jarnevanmulders/IoT_energystorage_charger/README.md

# IoT energystorage charger

Designed to charge single LTO (Lithium Titanate Oxide) cell.

## Onboard features
- Constant current constant voltage buck converter charger.
- Overvoltage and undervoltage protection.
- MCU enter _stop mode_ when not charging.
- Load switches to disconnect LTO cell from buck converter output.

## Image hardware
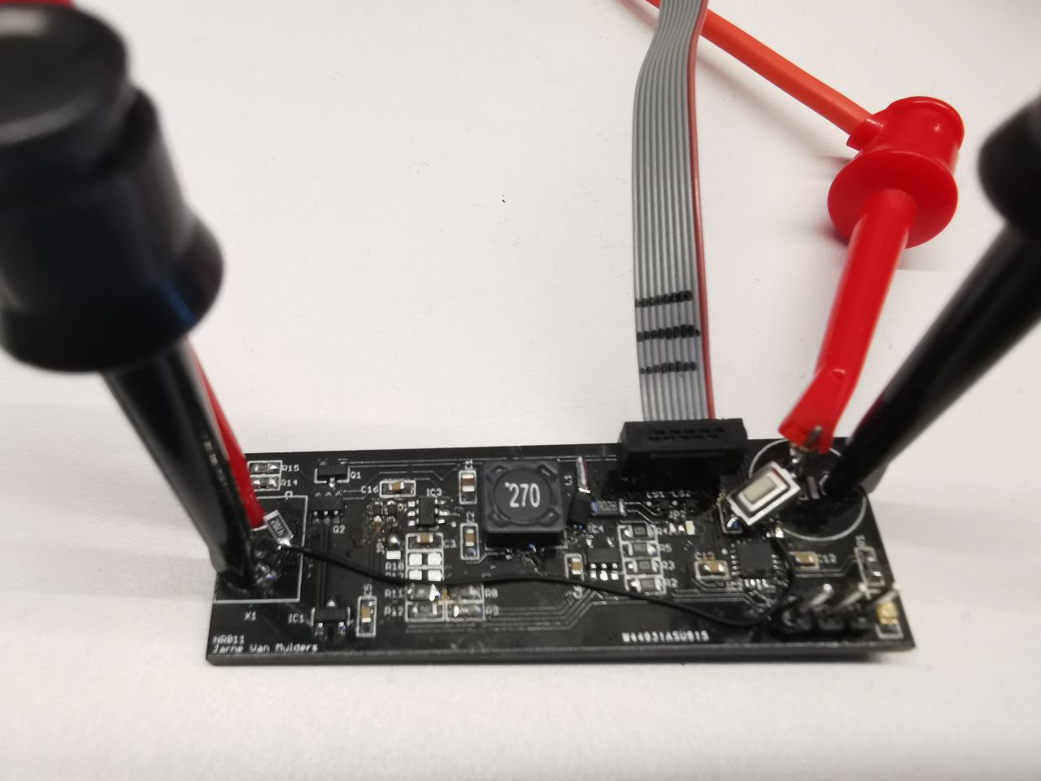
[picture p1: images/Hardware-image-1.jpg]
Image hardware
