jarnevanmulders/IoT_energystorage_charger/eagle-files/SVG-files/top.png

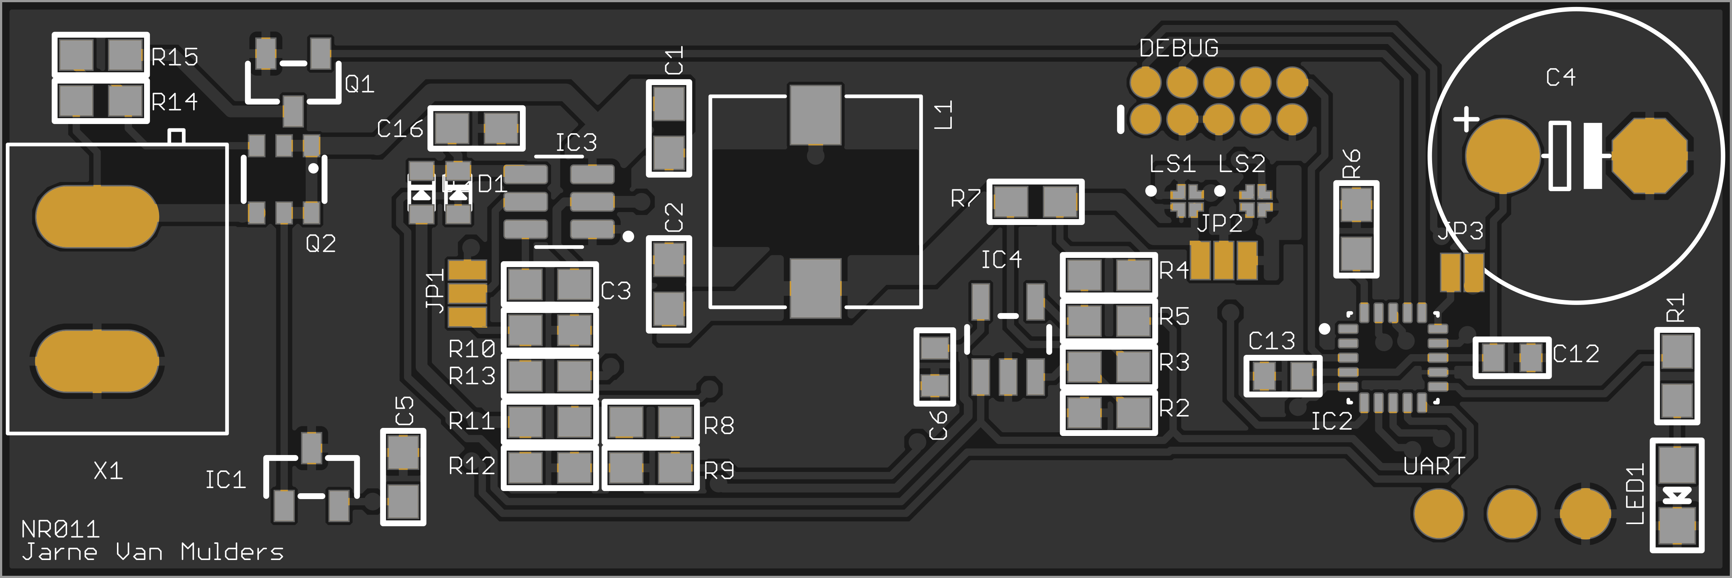
eagle-files/SVG-files/top.png
