jarnevanmulders/IoT_energystorage_charger/eagle-files/design1.pdf

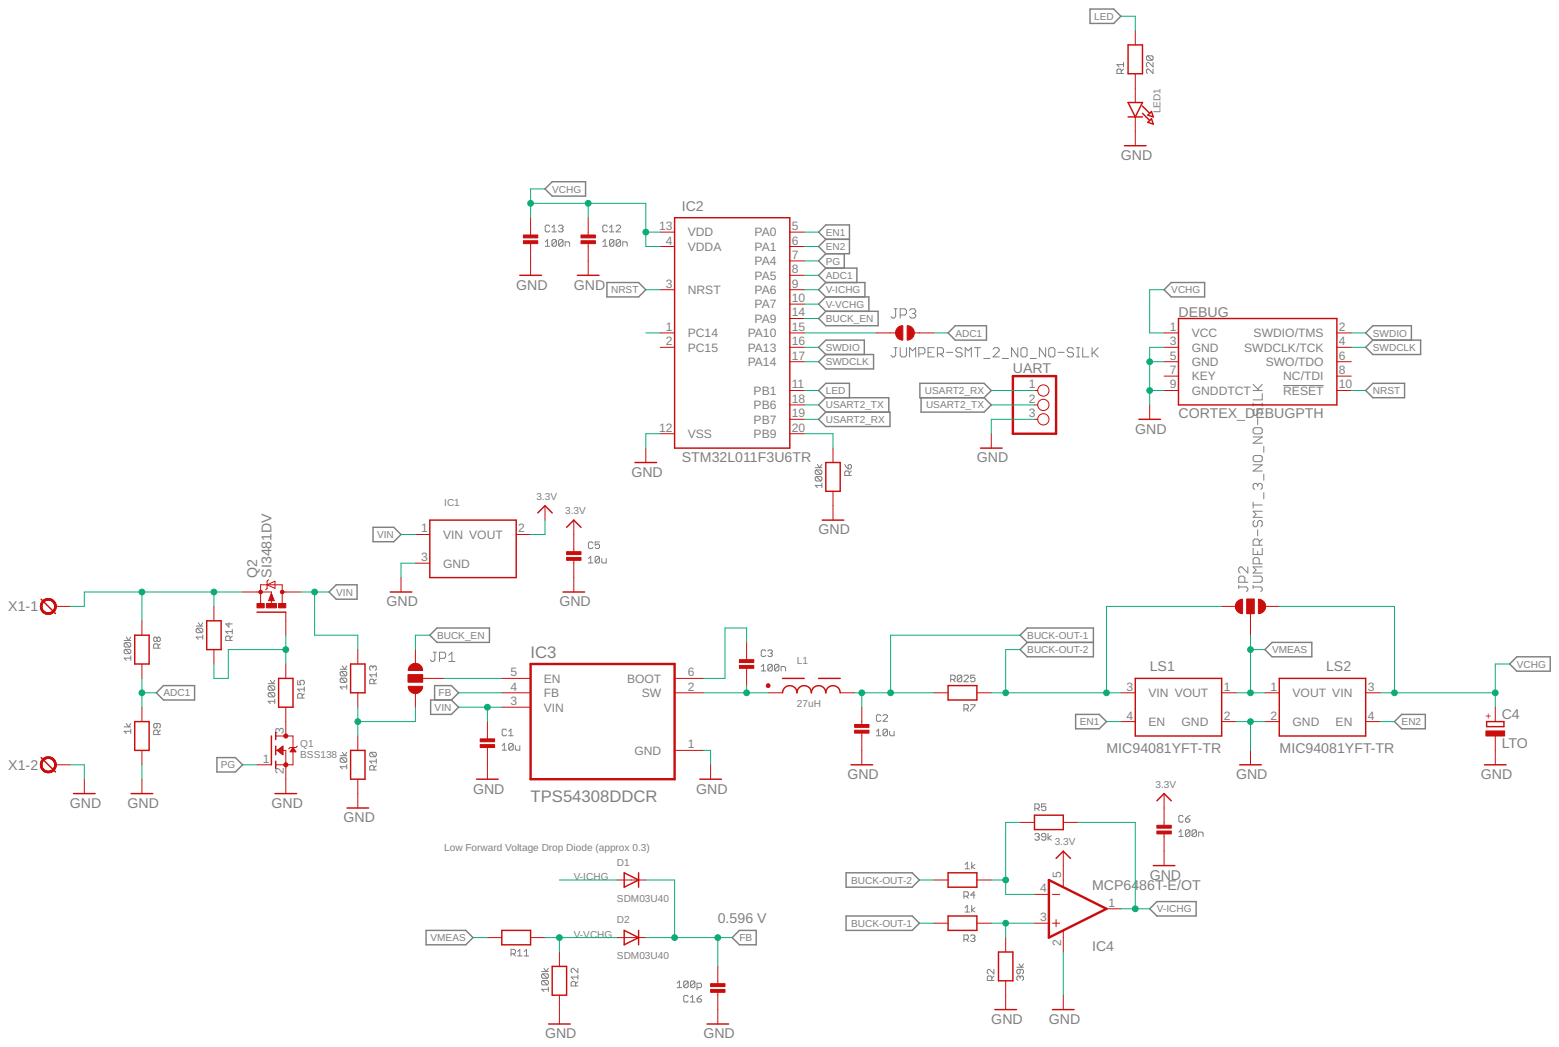
[picture p3: page 1]

Low Forward Voltage Drop Diode (approx 0.3)
