jarnevanmulders/IoT_energystorage_charger/eagle-files/design1.sch

## EAGLE design eagle-files/design1.sch (2023-06-15)

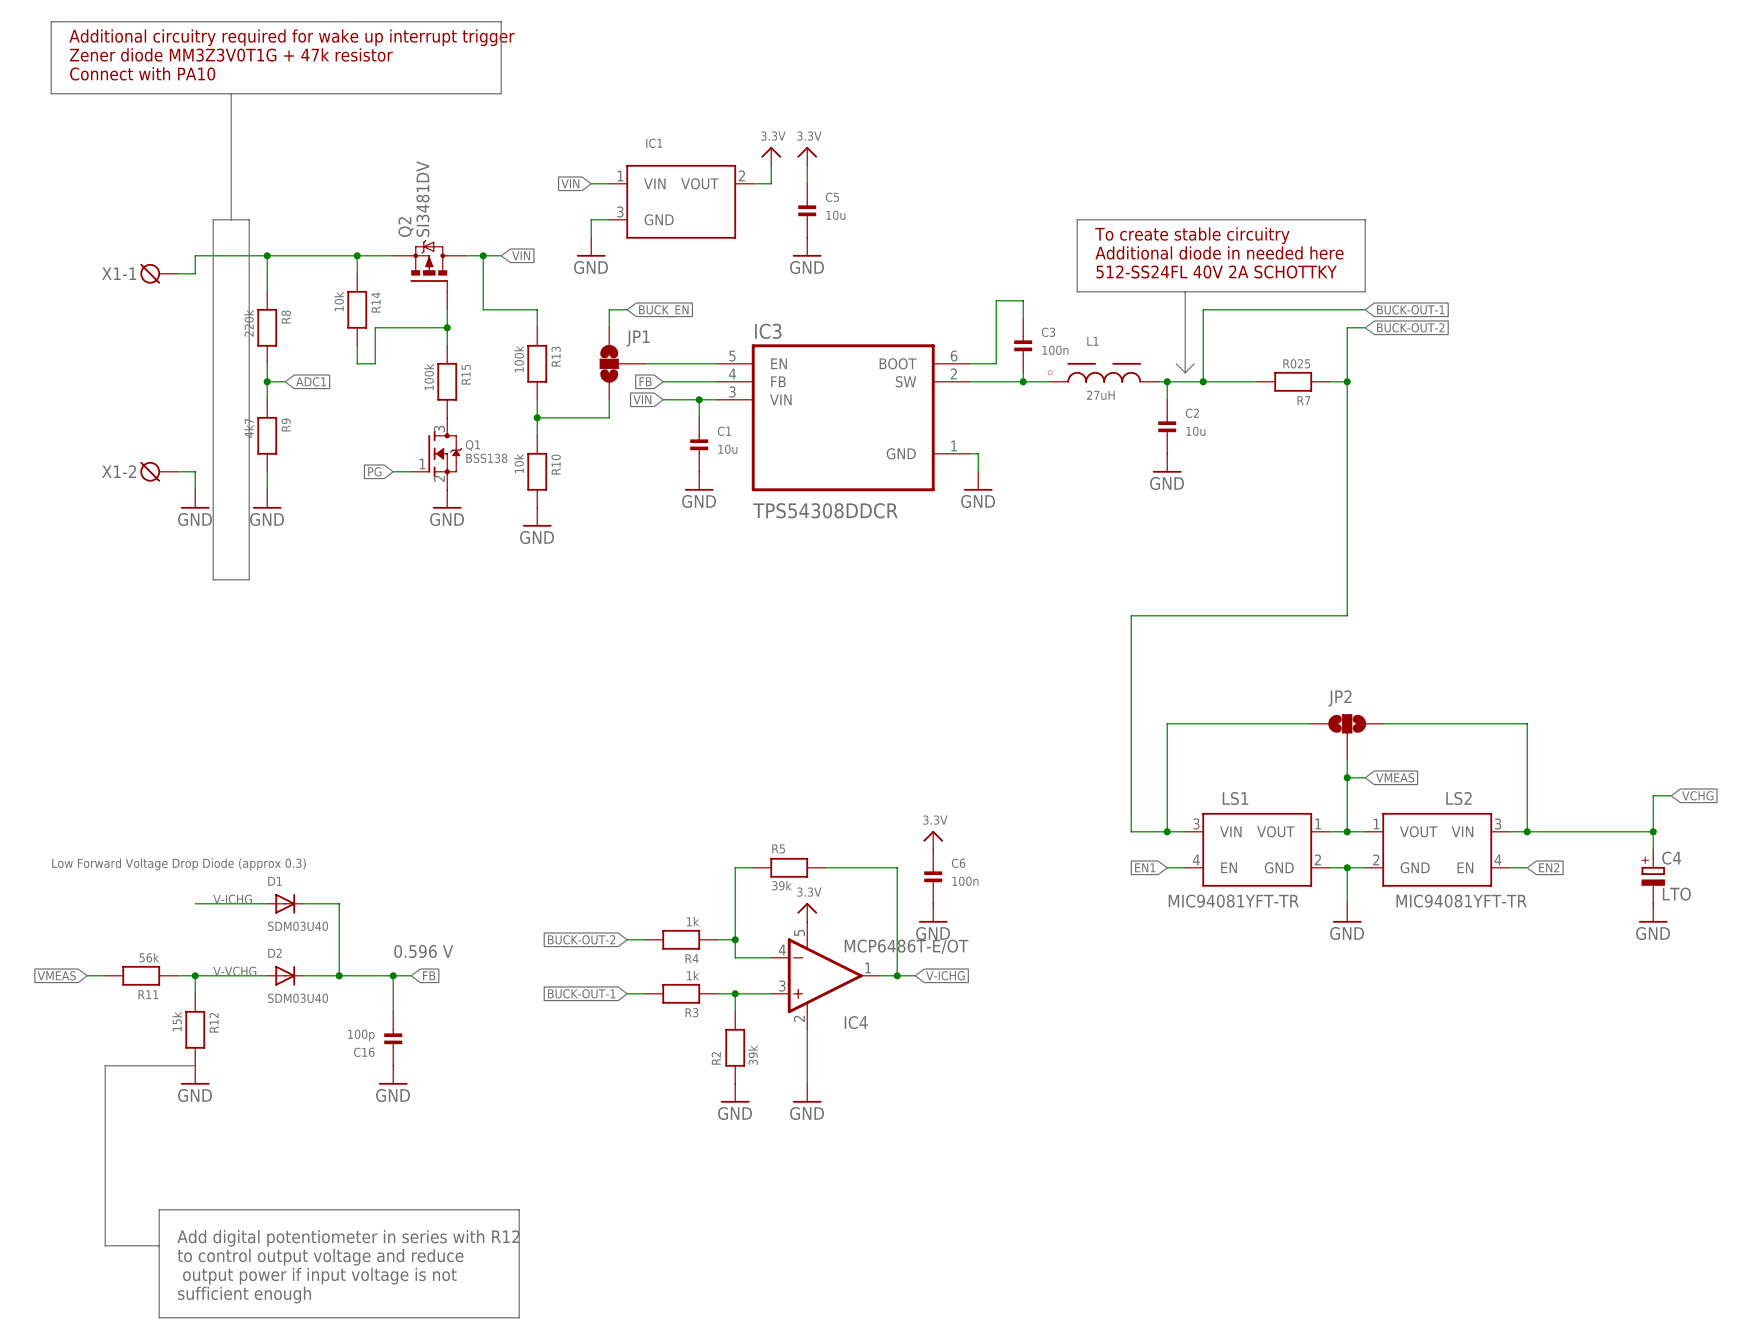
[picture p4: schematic design1.sch, sheet 1]

Parts:
C1, C2, C5: 10u; 0603
C3: 100n; 0603
C4: LTO; E5-10,5
C6: 100n; 0402
C16: 100p; 0603
D1, D2: SDM03U40; SOD-523
IC1: VREG_SOT23; SOT23-R
IC3: TPS54308DDCR; SOT95P280X110-6N
IC4: MCP6486T-E/OT; SOT23-5
JP1, JP2: JUMPER-SMT_3_NO_NO-SILK; SMT-JUMPER_3_NO_NO-SILK
L1: 27uH; WE-PD_7332/7345_PLASTIC_BASE
LS1, LS2: MIC94081YFT-TR; IC_MIC94081YFT-TR
Q1: BSS138; SOT23-R
Q2: SI3481DV; TSOP-6.PAC
R2, R5: 39k; 0603
R3, R4: 1k; 0603
R7: R025; 0603
R8: 220k; 0603
R9: 4k7; 0603
R10, R14: 10k; 0603
R11: 56k; 0603
R12: 15k; 0603
R13, R15: 100k; 0603
X1: DG3XX-02-5.0; DG306-5.0-02P

Connections:
3.3V: C5.1, C6.1, IC1.2 (VOUT), IC4.5 (V+)
ADC1: R8.2, R9.1
BUCK-OUT-1: C2.1, L1.2, R3.2, R7.2
BUCK-OUT-2: JP2.1, LS1.3 (VIN), R4.2, R7.1
BUCK_EN: JP1.3
EN1: LS1.4 (EN)
EN2: LS2.4 (EN)
FB: C16.2, D1.K (C), D2.K (C), IC3.4 (FB)
GND: C1.2, C2.2, C4.-, C5.2, C6.2, C16.1, IC1.3 (GND), IC3.1 (GND), IC4.2 (V-), LS1.2 (GND), LS2.2 (GND), Q1.2 (S), R2.1, R9.2, R10.2, R12.2, X1.2
unnamed: JP1.1, R10.1, R13.2
unnamed: C3.1, IC3.6 (BOOT)
unnamed: C3.2, IC3.2 (SW), L1.1
unnamed: Q1.3 (D), R15.2
unnamed: Q2.3 (G), R14.2, R15.1
unnamed: IC3.5 (EN), JP1.2
unnamed: IC4.4 (-IN), R4.1, R5.1
unnamed: IC4.3 (+IN), R2.2, R3.1
unnamed: Q2.4 (S), R8.1, R14.1, X1.1
PG: Q1.1 (G)
V-ICHG: D1.A, IC4.1 (OUT), R5.2
V-VCHG: D2.A, R11.1, R12.1
VCHG: C4.+, JP2.3, LS2.3 (VIN)
VIN: C1.1, IC1.1 (VIN), IC3.3 (VIN), Q2.1 (D), R13.1
VMEAS: JP2.2, LS1.1 (VOUT), LS2.1 (VOUT), R11.2

Notes on the sheet:
Low Forward Voltage Drop Diode (approx 0.3)
0.596 V
To create stable circuitry Additional diode in needed here 512-SS24FL 40V 2A SCHOTTKY
Additional circuitry required for wake up interrupt trigger Zener diode MM3Z3V0T1G + 47k resistor Connect with PA10
Add digital potentiometer in series with R12 to control output voltage and reduce output power if input voltage is not sufficient enough

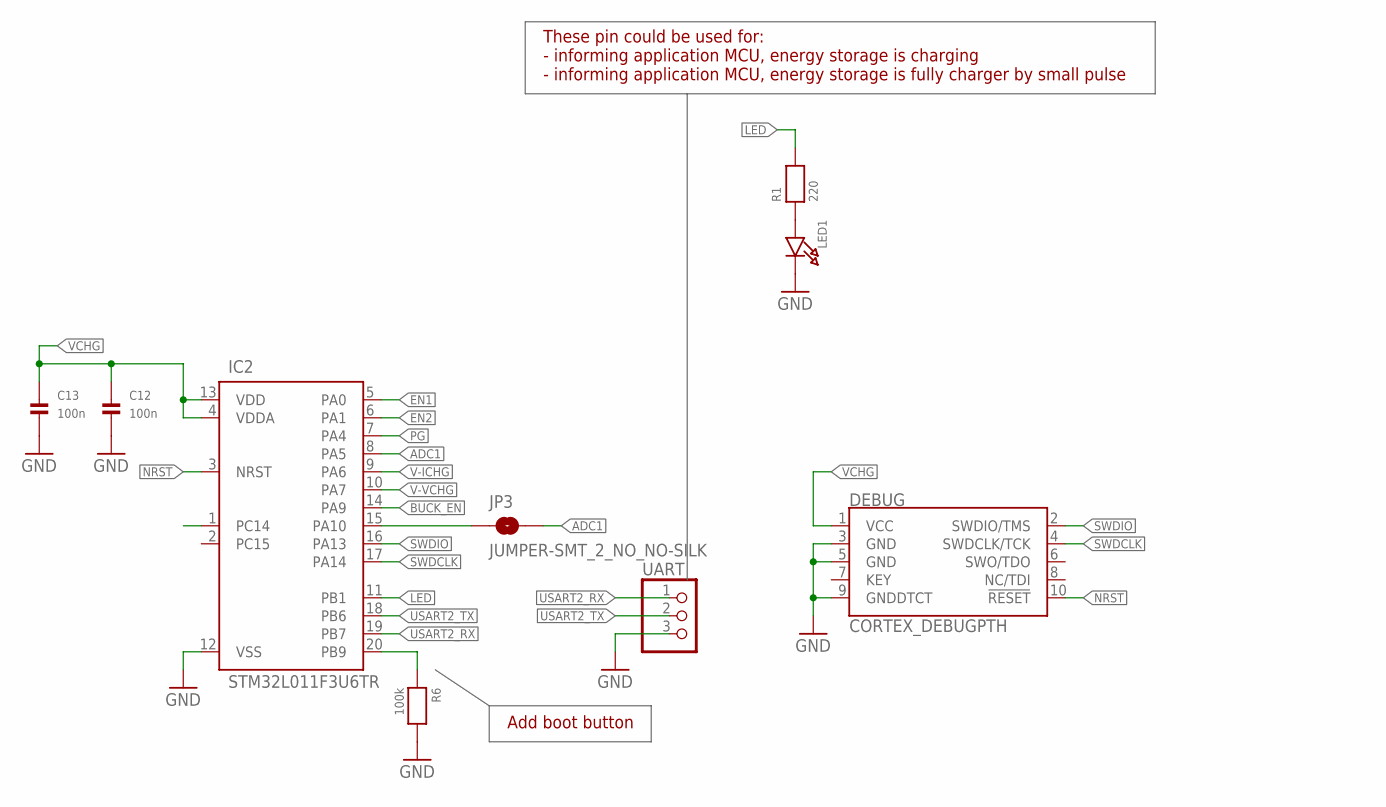
[picture p5: schematic design1.sch, sheet 2]

Parts:
C12, C13: 100n; 0402
DEBUG: CORTEX_DEBUGPTH; 2X5-PTH-1.27MM
IC2: STM32L011F3U6TR; QFN50P300X300X60-21N
JP3: JUMPER-SMT_2_NO_NO-SILK; SMT-JUMPER_2_NO_NO-SILK
LED1: LED0805; CHIPLED_0805
R1: 220; 0603
R6: 100k; 0603
UART: HEADER-1X3ROUND; 1X03_ROUND

Connections:
ADC1: IC2.8 (PA5), JP3.2
BUCK_EN: IC2.14 (PA9)
EN1: IC2.5 (PA0)
EN2: IC2.6 (PA1)
GND: C12.2, C13.2, DEBUG.3 (GND), DEBUG.5 (GND), DEBUG.9 (GNDDTCT), IC2.12 (VSS), LED1.C, R6.2, UART.3
LED: IC2.11 (PB1), R1.2
unnamed: IC2.15 (PA10), JP3.1
unnamed: LED1.A, R1.1
NRST: DEBUG.10 (!RESET), IC2.3 (NRST)
PB9: IC2.20 (PB9), R6.1
PG: IC2.7 (PA4)
SWDCLK: DEBUG.4 (SWDCLK/TCK), IC2.17 (PA14)
SWDIO: DEBUG.2 (SWDIO/TMS), IC2.16 (PA13)
USART2_RX: IC2.19 (PB7), UART.1
USART2_TX: IC2.18 (PB6), UART.2
V-ICHG: IC2.9 (PA6)
V-VCHG: IC2.10 (PA7)
VCHG: C12.1, C13.1, DEBUG.1 (VCC), IC2.4 (VDDA), IC2.13 (VDD)
VDD-AUX-EN: IC2.1 (PC14)

Notes on the sheet:
Add boot button
These pin could be used for: - informing application MCU, energy storage is charging - informing application MCU, energy storage is fully charger by small pulse
