jarnevanmulders/IoT_energystorage_charger/firmware-vscode-16kb-flash/Core/Src/main.c

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
/* Includes ------------------------------------------------------------------*/
#include "main.h"

/* USER CODE BEGIN PD */

#define VREFINT_CAL_ADDR          ((uint16_t*) ((uint32_t) 0x1FF80078))
#define MIN_VOLTAGE               5000
#define MAX_VOLTAGE               22000
#define MIN_CURRENT               200
#define SLEEP_VOLTAGE             1000
#define MIN_CHARGE_CUTTOF_VOLTAGE 2600

/* USER CODE END PD */

ADC_HandleTypeDef hadc;

SPI_HandleTypeDef hspi1;

TIM_HandleTypeDef htim2;

UART_HandleTypeDef huart2;

void SystemClock_Config(void);
static void MX_GPIO_Init(void);
static void MX_ADC_Init(void);
static void MX_USART2_UART_Init(void);
static void MX_SPI1_Init(void);
static void MX_TIM2_Init(void);
/* USER CODE BEGIN PFP */

// *** Load switch functions *** //
void load_switch_enable(void);
void load_switch_disable(void);

// *** Blocking led functions *** //
void led_blink(uint16_t time_delay_1, uint16_t time_delay_2);

// *** Non blocking led functios *** //
void led_blink_nb(uint16_t time_delay_1, uint16_t time_delay_2);

// *** SAFELY ENABLE/DISABLE BUCK CONVERTER *** //
void Enable_buck_converter(void);
void Disable_buck_converter(void);

// *** Calculate CRC *** //
uint8_t calculate_crc_xor(const uint8_t *data, size_t length);

/* USER CODE END PFP */

/* USER CODE BEGIN 0 */

uint16_t ADC_CH5, ADC_CH6, ADC_CH7, ADC_REF;
uint16_t supply_voltage_mv = 0;
uint16_t input_voltage_mv = 0;
uint16_t buck_output_voltage_mv = 0;
uint16_t buck_current_ma = 0;
uint8_t previous_state = 0;
uint16_t timer_check = 0;

// Non blocking blink  
uint8_t isOn;
uint32_t timestamp;

// Send message
uint8_t send_status = 1;

// Buffer keeping SPI commands to change resistance of programmable potentiometer 
uint8_t spi_buffer [2] = {0, 0};

// State machine
typedef enum {INIT, START_CHARGING, CHARGING, STOP_CHARGING, OVER_VOLTAGE, SLEEP} State_type;
State_type current_state = INIT;

/* USER CODE END 0 */

/**
  * @brief  The application entry point.
  * @retval int
  */
int main(void)
{
  /* MCU Configuration--------------------------------------------------------*/

  /* Reset of all peripherals, Initializes the Flash interface and the Systick. */
  HAL_Init();

  /* Configure the system clock */
  SystemClock_Config();

  /* Initialize all configured peripherals */
  MX_GPIO_Init();
  MX_ADC_Init();
  MX_USART2_UART_Init();
  MX_SPI1_Init();
  MX_TIM2_Init();
  /* USER CODE BEGIN 2 */

  // Calibrate ADC
  HAL_ADCEx_Calibration_Start(&hadc, ADC_SINGLE_ENDED);

  // Start timer
  HAL_TIM_Base_Start_IT(&htim2);

  /* USER CODE END 2 */

  /* Infinite loop */
  /* USER CODE BEGIN WHILE */
  while (1)
  {
    /* USER CODE END WHILE */

    /* USER CODE BEGIN 3 */

    // Delay (prevent sampling ADC to quickly)
    HAL_Delay(100);

    // Start ADC Conversion and read two ADC values
		HAL_ADC_Start(&hadc);
    
    // ADC_CHANNEL_5 & Read The ADC Conversion Result
    HAL_ADC_PollForConversion(&hadc, 100);
		ADC_CH5 = HAL_ADC_GetValue(&hadc);

    // ADC_CHANNEL_6 & Read The ADC Conversion Result
    HAL_ADC_PollForConversion(&hadc, 100);
		ADC_CH6 = HAL_ADC_GetValue(&hadc);

    // ADC_CHANNEL_7 & Read The ADC Conversion Result
    HAL_ADC_PollForConversion(&hadc, 100);
		ADC_CH7 = HAL_ADC_GetValue(&hadc);

    // ADC_CHANNEL_VREFINT & Read The ADC Conversion Result
    HAL_ADC_PollForConversion(&hadc, 100);
		ADC_REF = HAL_ADC_GetValue(&hadc);

    // Stop ADC Conversion
    HAL_ADC_Stop(&hadc);

    // Calculate supply voltage MCU
    supply_voltage_mv = 1200*4096/ADC_REF;

    // Calculate input voltage BUCK converter
    input_voltage_mv = ADC_CH5*supply_voltage_mv/4096*224700/4700;

    // Calculate buck converter output voltage
    buck_output_voltage_mv = ADC_CH7*supply_voltage_mv/4096*71000/15000;

    // Calculate buck converter output current
    buck_current_ma = ADC_CH6*supply_voltage_mv/4096*1000/780;


    if(input_voltage_mv > MAX_VOLTAGE){
      current_state = OVER_VOLTAGE;
    }

    
    ///////////////////////////
    // *** State machine *** //
    ///////////////////////////

    switch (current_state){
      case INIT:
        // No charging may occur in the INIT phase
        Disable_buck_converter();

        // Check input voltage before start charging
        if(input_voltage_mv < MAX_VOLTAGE && input_voltage_mv > MIN_VOLTAGE){
          current_state = START_CHARGING;
          break;
        }

        // Check input voltage in not below minimum voltage
        if(input_voltage_mv < SLEEP_VOLTAGE){
          current_state = SLEEP;
        }

        HAL_GPIO_WritePin(SC_GPIO_Port, SC_Pin, GPIO_PIN_RESET);
        spi_buffer[1] = 100;
        HAL_SPI_Transmit(&hspi1, spi_buffer, 2, 100);
        HAL_GPIO_WritePin(SC_GPIO_Port, SC_Pin, GPIO_PIN_SET);

        // Blink led
        led_blink_nb(500, 500);
      break;
      case START_CHARGING: 
        // Enable buck converter safely
        Enable_buck_converter();

        // Change state
        current_state = CHARGING;
      break;
      case CHARGING:
        led_blink_nb(100, 900);

        // If under voltage occurs, wait for enough voltage to resume
        if(input_voltage_mv < MIN_VOLTAGE){
          current_state = INIT;
          break;
        }

        // Check for current lower then MIN_CURRENT after 10 sec
        if(buck_current_ma < MIN_CURRENT && timer_check > 10 && supply_voltage_mv > MIN_CHARGE_CUTTOF_VOLTAGE){
          timer_check = 0;
          current_state = STOP_CHARGING;
        }

        HAL_GPIO_WritePin(SC_GPIO_Port, SC_Pin, GPIO_PIN_RESET);
        spi_buffer[1] = 100;
        HAL_SPI_Transmit(&hspi1, spi_buffer, 2, 200);
        HAL_GPIO_WritePin(SC_GPIO_Port, SC_Pin, GPIO_PIN_SET);

        timer_check++;

      break;
      case STOP_CHARGING:
        // Disable buck conveter safely
        Disable_buck_converter();

        // SEND MESSAGE TO TRANSMITTER

        // if(buck_current_ma < MIN_CURRENT && supply_voltage_mv > MIN_CHARGE_CUTTOF_VOLTAGE){
        //   current_state = SLEEP;
        // }
        // else{
        //   current_state = INIT;
        // }
        current_state = SLEEP;
      break;
      case OVER_VOLTAGE:
        led_blink_nb(100, 100);

        // Disable buck conveter safely
        Disable_buck_converter();

        // Check for save voltage
        if(input_voltage_mv < MAX_VOLTAGE){
          current_state = INIT;
        }
      break;
      case SLEEP:

        // Disable LED
        HAL_GPIO_WritePin(LED_GPIO_Port, LED_Pin, GPIO_PIN_RESET);

        // Check if input voltage is above 2 V and enable timer interrupt

        // Reconfigure GPIO pins for sleep mode: EN1_Pin EN2_Pin PG_Pin BUCK_EN_Pin
        // GPIO_InitTypeDef GPIO_InitStruct;
        // GPIO_InitStruct.Pin = EN1_Pin|EN2_Pin|PG_Pin|BUCK_EN_Pin;
        // GPIO_InitStruct.Mode = GPIO_MODE_ANALOG;
        // GPIO_InitStruct.Pull = GPIO_NOPULL;
        // HAL_GPIO_Init(GPIOA, &GPIO_InitStruct);
        
        // Disable the systick interrupt
        HAL_SuspendTick();

        // Enter Stop Mode
        HAL_PWR_EnterSTOPMode(PWR_LOWPOWERREGULATOR_ON, PWR_STOPENTRY_WFI);

        // Change state
        current_state = INIT;

      break;
      default:
      current_state = INIT;
      break;
    }

    if(send_status){
      send_status = 0;
      uint8_t length = 11;
      uint8_t buffer [length];
      buffer [0] = 0x02;
      buffer [1] = length;
      buffer [2] = (input_voltage_mv >> 8);
      buffer [3] = (uint8_t)(input_voltage_mv);
      buffer [4] = (buck_output_voltage_mv >> 8);
      buffer [5] = (uint8_t)(buck_output_voltage_mv);
      buffer [6] = (buck_current_ma >> 8);
      buffer [7] = (uint8_t)(buck_current_ma);
      buffer [8] = (supply_voltage_mv >> 8);
      buffer [9] = (uint8_t)(supply_voltage_mv);
      buffer [10] = calculate_crc_xor(buffer, length-1);//0xFF;
      HAL_UART_Transmit(&huart2, buffer, length, 100);
    }

  }
  /* USER CODE END 3 */
}

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
/* USER CODE BEGIN 4 */

// *** Load Switch functions *** //
// Enable load switch 1 and 2
void load_switch_enable(void){
  HAL_GPIO_WritePin(EN1_GPIO_Port, EN1_Pin, GPIO_PIN_SET);
  HAL_GPIO_WritePin(EN2_GPIO_Port, EN2_Pin, GPIO_PIN_SET);
}

// Disable load switch 1 and 2
void load_switch_disable(void){
  HAL_GPIO_WritePin(EN1_GPIO_Port, EN1_Pin, GPIO_PIN_RESET);
  HAL_GPIO_WritePin(EN2_GPIO_Port, EN2_Pin, GPIO_PIN_RESET);
}

void led_blink(uint16_t time_delay_1, uint16_t time_delay_2){
  HAL_GPIO_WritePin(LED_GPIO_Port, LED_Pin, GPIO_PIN_RESET);
  HAL_Delay(time_delay_1);
  HAL_GPIO_WritePin(LED_GPIO_Port, LED_Pin, GPIO_PIN_SET);
  HAL_Delay(time_delay_2);
}

void led_blink_nb(uint16_t time_delay_1, uint16_t time_delay_2){
  uint32_t currentTime = HAL_GetTick();  // Get current timestamp (implementation-dependent)

  if (isOn) {
    if (currentTime - timestamp >= time_delay_1) {
      isOn = 0;
      timestamp = currentTime;
      HAL_GPIO_WritePin(LED_GPIO_Port, LED_Pin, GPIO_PIN_RESET);
    }
  } else {
    if (currentTime - timestamp >= time_delay_2) {
      isOn = 1;
      timestamp = currentTime;
      HAL_GPIO_WritePin(LED_GPIO_Port, LED_Pin, GPIO_PIN_SET);
    }
  }
}

// *** WAKE UP *** //
void HAL_GPIO_EXTI_Callback(uint16_t GPIO_Pin)
{
  //if(GPIO_Pin == INT_Pin)
  //{
	  SystemClock_Config();
	  HAL_ResumeTick();
  //}
}

// *** SAFELY ENABLE/DISABLE BUCK CONVERTER *** //
void Enable_buck_converter(void){
  // Enable load switches
  load_switch_enable();

  HAL_Delay(100);

  // Enable CC/CV buck converter
  HAL_GPIO_WritePin(BUCK_EN_GPIO_Port, BUCK_EN_Pin, GPIO_PIN_SET);

  // Connect input voltage to buck converter
  HAL_GPIO_WritePin(PG_GPIO_Port, PG_Pin, GPIO_PIN_SET);
}


void Disable_buck_converter(void){
    // Disable CC/CV buck converter
  HAL_GPIO_WritePin(BUCK_EN_GPIO_Port, BUCK_EN_Pin, GPIO_PIN_RESET);
  
  // Disconnect input voltage from buck converter
  HAL_GPIO_WritePin(PG_GPIO_Port, PG_Pin, GPIO_PIN_RESET);

  // Disable load switches
  load_switch_disable();
}

// *** TIMER INTEGRATION *** //
void HAL_TIM_PeriodElapsedCallback(TIM_HandleTypeDef* htim){
  send_status = 1;
}


// *** Calculate CRC *** //
uint8_t calculate_crc_xor(const uint8_t *data, size_t length) {
    uint8_t crc = 0;
    size_t i;

    for (i = 0; i < length; i++) {
        crc ^= data[i];
    }

    return crc;
}

/* USER CODE END 4 */
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
