jarnevanmulders/IoT_energystorage_charger/(commit log)

2023-03-30 Add input voltage protection
2023-04-04 Update hardware + add state machine
    Software: Add state machine
    Hardware: Add EXT interrupt zener diode
    Hardware: Add diode to prevent buck converter reverse current
    [design1.sch]
2023-04-04 Update scheme eagle
    [design1.sch]
2023-06-12 Update 16kb flash + monitoring python script
    [efficiency-charger.csv]
2023-06-12 Measure efficiency charger and update firmware
    [meas-eff-235ma-2674mv.csv, meas-eff-327ma-2660mv.csv, meas-eff-700ma-2400mv.csv, meas-eff-720ma-2100mv.csv]
2023-06-16 GPIO outputs reconfigured + SPI and TIM2 configured
    Test SPI code to control digital potentiometer
2023-06-19 Update non blocking blink + ADC cannot be sampled to fast
2023-06-26 Updated firmware can handle low amounts of receive power
    Digital potentiometer reduces charger voltage if input voltage is not sufficiently high.
2023-06-29 Changes to PCB required
    [design1.sch]
