jarnevanmulders/IoT_energystorage_charger/(notices)

Notices in the files:
firmware-vscode-16kb-flash/Core/Src/main.c:
Copyright (c) 2023 STMicroelectronics.
All rights reserved.
This software is licensed under terms that can be found in the LICENSE file
parts and their libraries:
microbuilder: This work is placed in the public domain, and may be freely used for commercial and non-commercial work with the following conditions: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
EMCComponents: Copyright: Würth Elektronik
